XuanThucNgo/IOT_Project/About.jpg

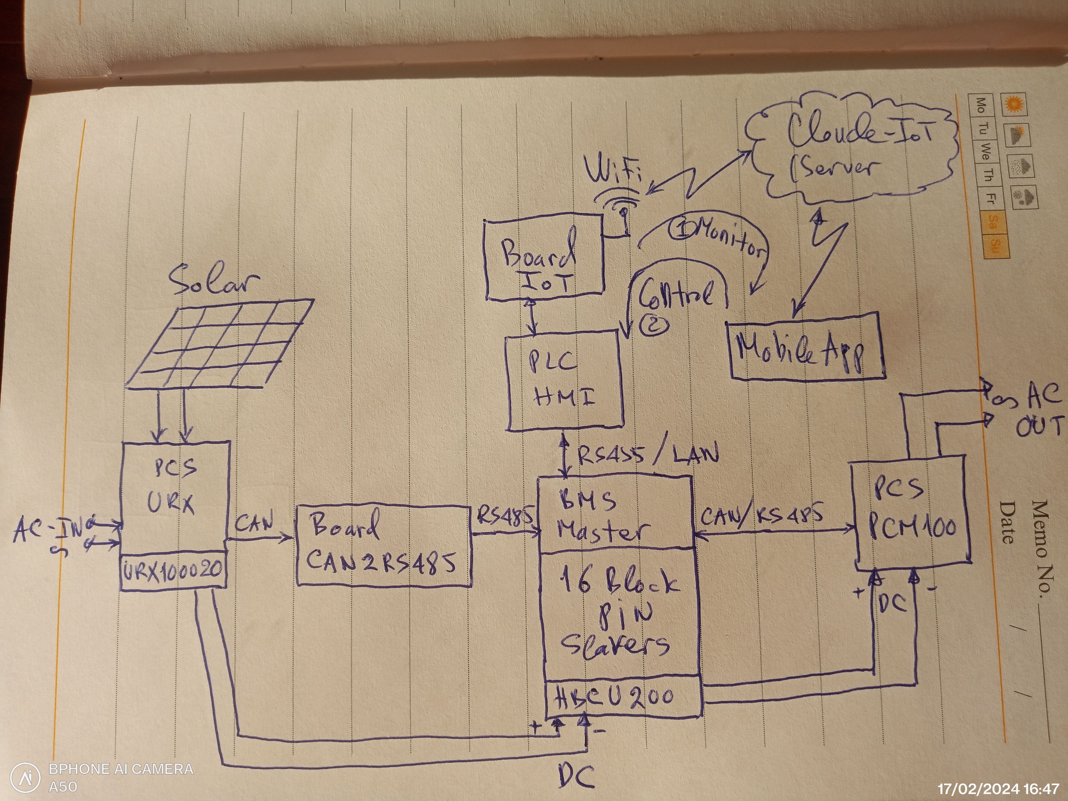
About.jpg
