XuanThucNgo/IOT_Project/trạm sạc xe máy điện.pdf

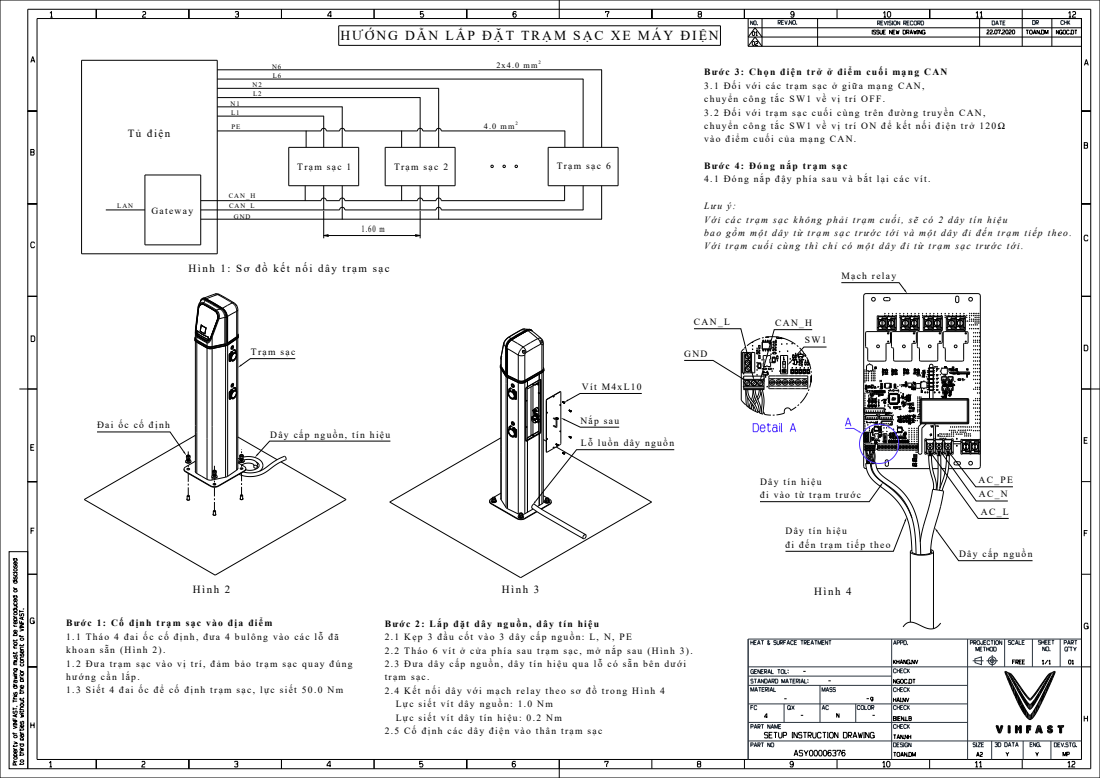
[picture p2: page 1]
Hình 2; Trạm sạc; Hình 3; Mạch relay; Tủ điện; Gateway LAN; Trạm sạc 1; Trạm sạc 2; Trạm sạc 6

HƯỚNG DẪN LẮP ĐẶT TRẠM SẠC XE MÁY ĐIỆN

Bước 3: Chọn điện trở ở điểm cuối mạng CAN
3.1 Đối với các trạm sạc ở giữa mạng CAN,
chuyển công tắc SW1 về vị trí OFF.
3.2 Đối với trạm sạc cuối cùng trên đường truyền CAN,
chuyển công tắc SW1 về vị trí ON để kết nối điện trở 120Ω
vào điểm cuối của mạng CAN.
Bước 4: Đóng nắp trạm sạc
4.1 Đóng nắp đậy phía sau và bắt lại các vít.
Lưu ý:
Với các trạm sạc không phải trạm cuối, sẽ có 2 dây tín hiệu
bao gồm một dây từ trạm sạc trước tới và một dây đi đến trạm tiếp theo.
Với trạm cuối cùng thì chỉ có một dây đi từ trạm sạc trước tới.

CAN_H
CAN_L
GND
Hình 1: Sơ đồ kết nối dây trạm sạc

Vít M4xL10
Nắp sau
Lỗ luồn dây nguồn

Đai ốc cố định

Dây cấp nguồn, tín hiệu

Dây tín hiệu
đi vào từ trạm trước
đi đến trạm tiếp theo
Hình 4

Dây cấp nguồn

Bước 1: Cố định trạm sạc vào địa điểm
1.1 Tháo 4 đai ốc cố định, đưa 4 bulông vào các lỗ đã
khoan sẵn (Hình 2).
1.2 Đưa trạm sạc vào vị trí, đảm bảo trạm sạc quay đúng
hướng cần lắp.
1.3 Siết 4 đai ốc để cố định trạm sạc, lực siết 50.0 Nm

Bước 2: Lắp đặt dây nguồn, dây tín hiệu
2.1 Kẹp 3 đầu cốt vào 3 dây cấp nguồn: L, N, PE
2.2 Tháo 6 vít ở cửa phía sau trạm sạc, mở nắp sau (Hình 3).
2.3 Đưa dây cấp nguồn, dây tín hiệu qua lỗ có sẵn bên dưới
trạm sạc.
2.4 Kết nối dây với mạch relay theo sơ đồ trong Hình 4
Lực siết vít dây nguồn: 1.0 Nm
Lực siết vít dây tín hiệu: 0.2 Nm
2.5 Cố định các dây điện vào thân trạm sạc
