XuanThucNgo/IOT_Project/DuAnSacXeDien_V1.0.pdf

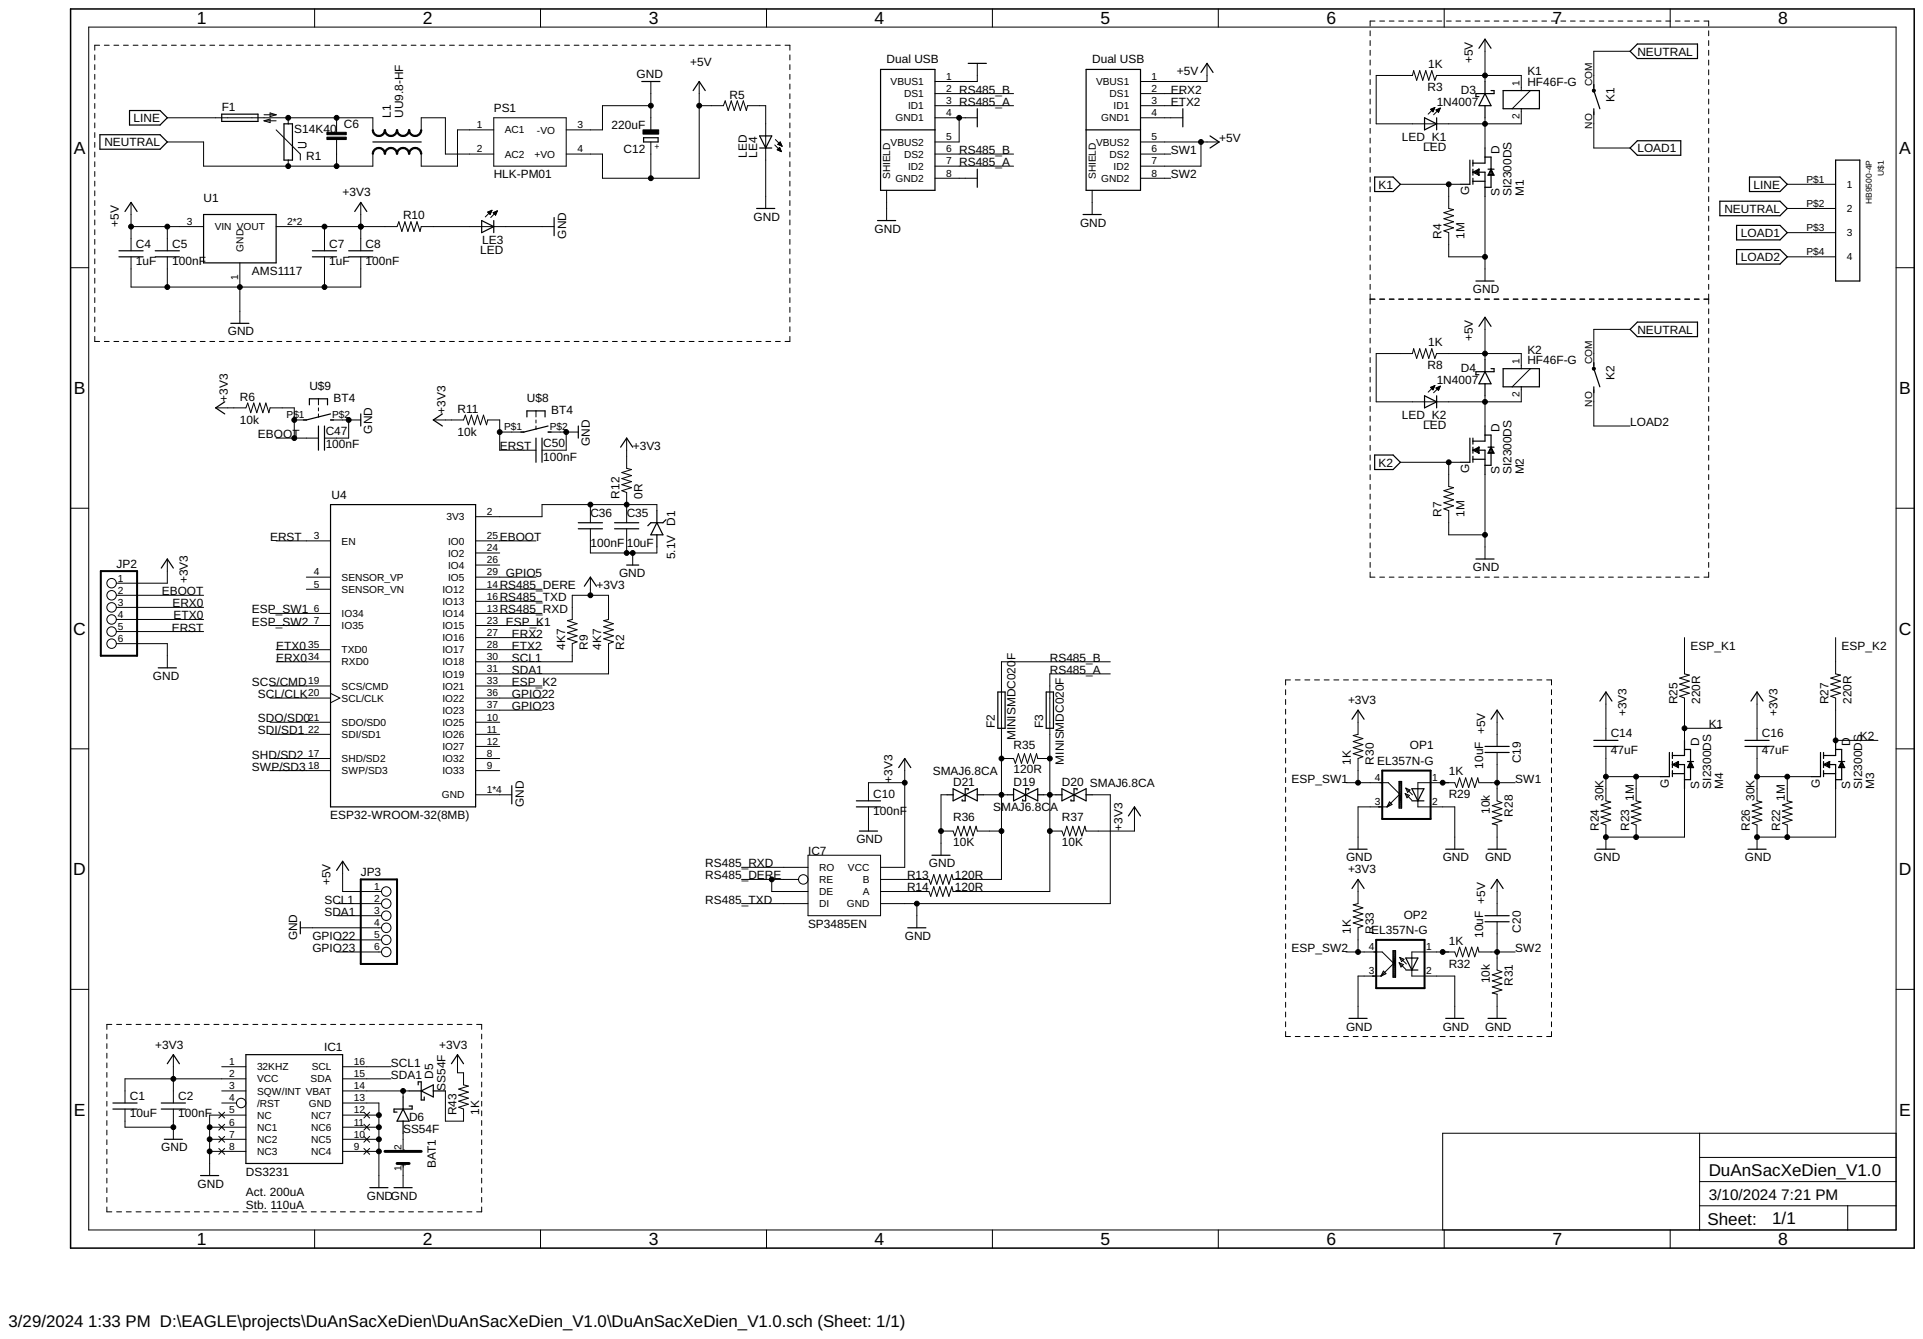
[picture p3: page 1]

3/29/2024 1:33 PM D:\EAGLE\projects\DuAnSacXeDien\DuAnSacXeDien_V1.0\DuAnSacXeDien_V1.0.sch (Sheet: 1/1)
