XuanThucNgo/IOT_Project/DuAnSacXeDien_V1.0.brd

## EAGLE design DuAnSacXeDien_V1.0.brd (2024-04-19)

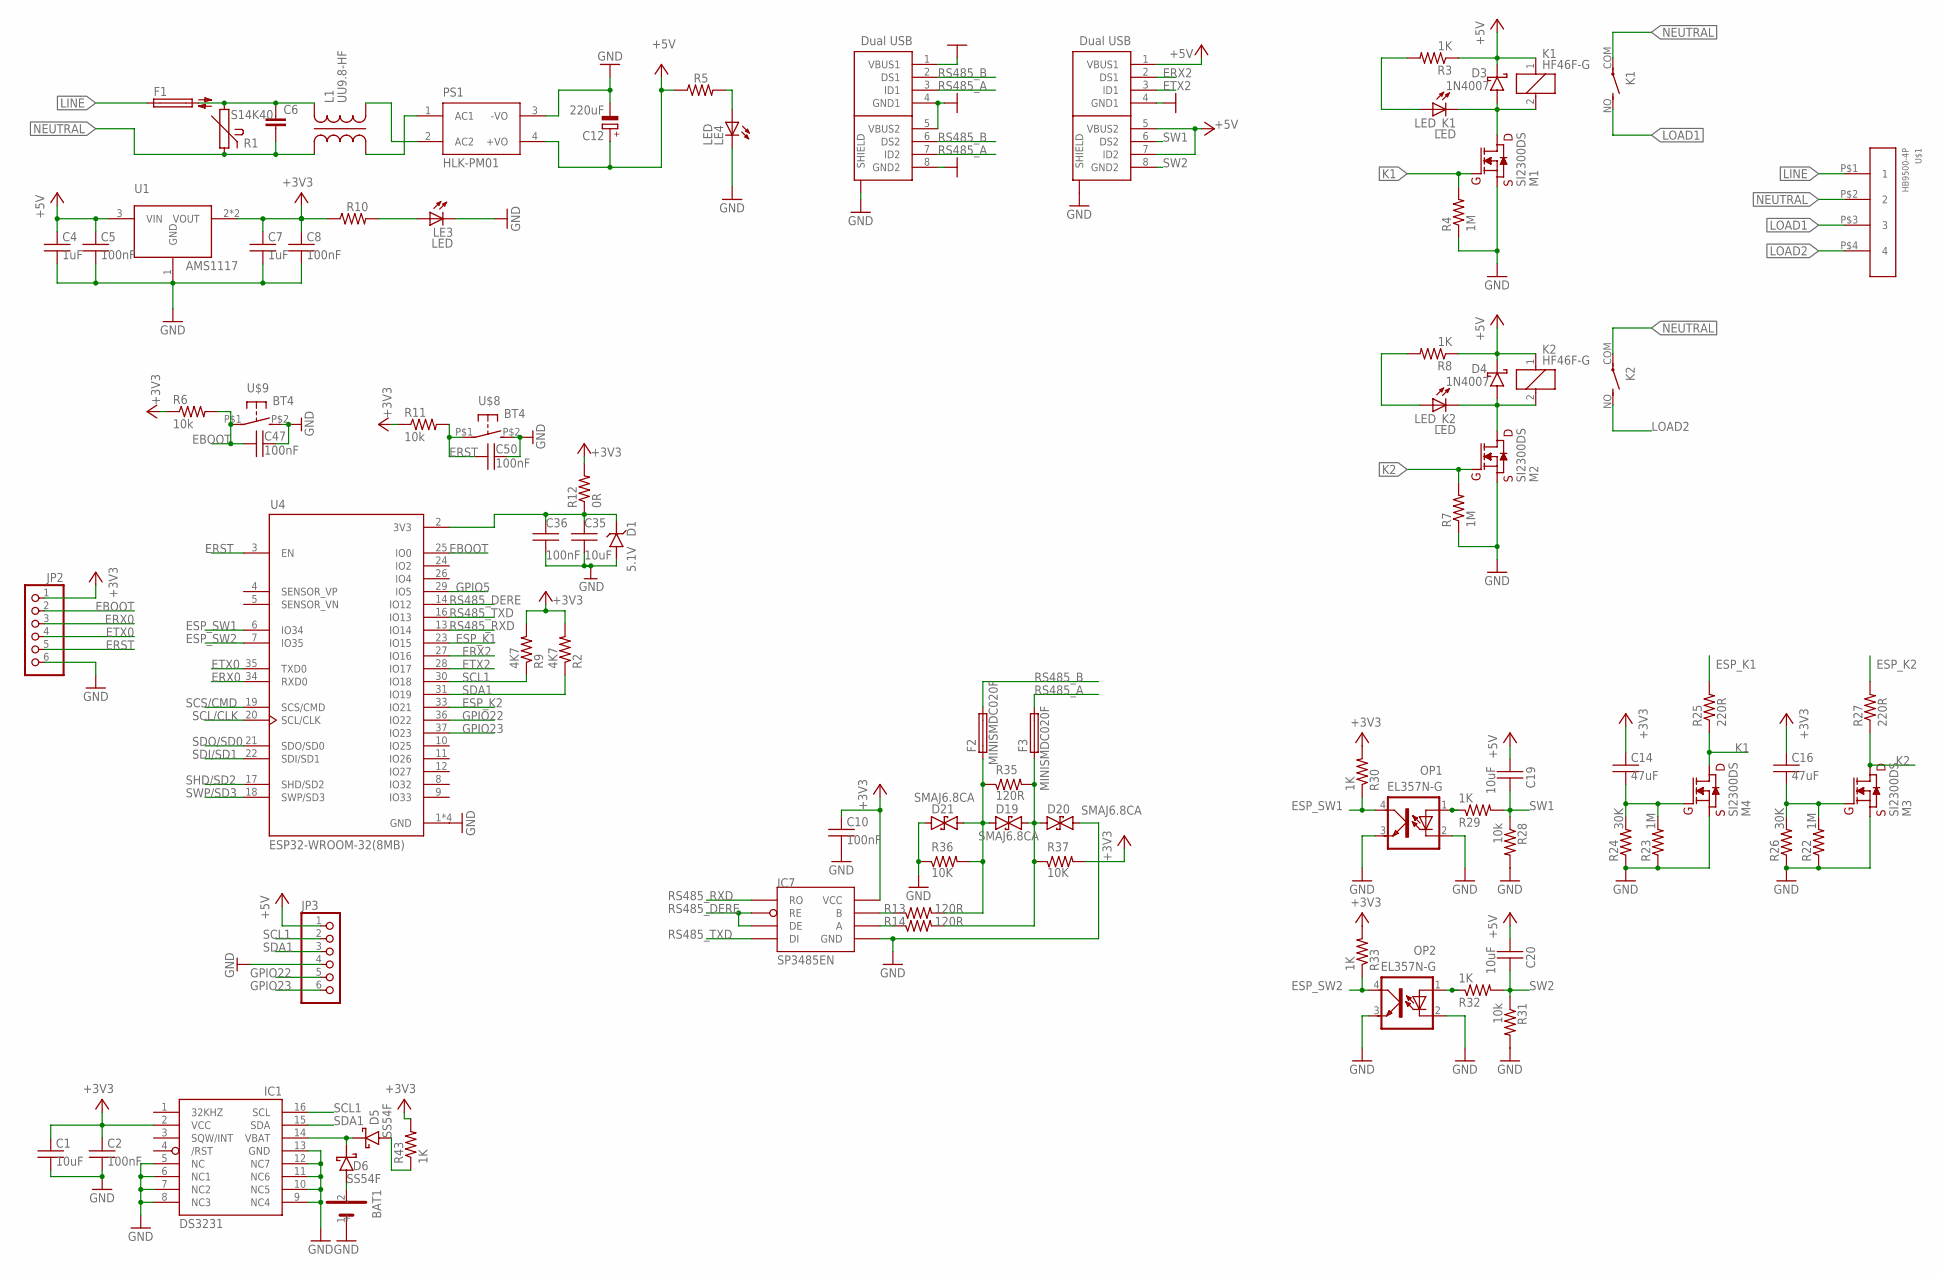
[picture p4: schematic DuAnSacXeDien_V1.0.sch]

Parts:
BAT1: CR1220
C1, C19, C20, C35: 10uF; 0603
C2, C5, C8, C10, C36, C47, C50: 100nF; 0603
C4, C7: 1uF; 0603
C6: C-EU150-064X183; C150-064X183
C12: 220uF; 153CLV-0605
C14, C16: 47uF; 0805
D1: 5.1V; SOD123
D3, D4: 1N4007; SMAF
D5, D6: SS54F; SMAF
D19, D20, D21: SMAJ6.8CA; DO-214AC-BI
F1: TE5
F2, F3: MINISMDC020F; C1812
IC1: DS3231/SO; SO16W
IC7: SP3485EN; SOIC-8
JP2: PINHD-1X6; 1X06
JP3: PINHD-1X6/LONG; 1X06
K1, K2: HF46F-G; LD
L1: UU9.8-HF
LE3, LE4: LED; LED3MM
LED_K1, LED_K2: LED; LED3MM
M1, M2, M3, M4: SI2300DS; SOT23(1)
OP1, OP2: EL357N-G; SOP4
PS1: HLK-PM01; HLK-PMXX
R1: S14K40
R2, R9: 4K7; 0603
R3, R5, R8, R10, R29, R30, R32, R33, R43: 1K; 0603
R4, R7, R22, R23: 1M; 0603
R6, R11, R28, R31: 10k; 0603
R12: 0R; 0603
R13, R14, R35: 120R; 0603
R24, R26: 30K; 0603
R25, R27: 220R; 0603
R36, R37: 10K; 0603
U1: LD1117; SOT223-3.3
U4: ESP32-WROOM-32(8MB); MODULE_ESP32-WROOM-32(8MB)
U$1: HB9500-4P
U$2, U$7: DUAL_USB
U$8, U$9: BT4

Connections:
+3V3: C1.1, C2.1, C7.1, C8.1, C10.1, C14.1, C16.1, IC1.2 (VCC), IC7.8 (VCC), JP2.1, R2.2, R6.1, R9.2, R10.1, R11.1, R12.2, R30.2, R33.2, R37.2, R43.2, U1.2 (VOUT), U1.4 (VOUT)
+5V: C4.1, C5.1, C12.+, C19.1, C20.1, D3.C, D4.C, JP3.1, K1.1, K2.1, PS1.4 (+VO), R3.1, R5.1, R8.1, U1.3 (VIN), U$2.1 (VBUS1), U$2.5 (VBUS2), U$2.7 (ID2)
EBOOT: C47.1, JP2.2, R6.2, U4.25 (IO0), U$9.P$1 (1)
ERST: C50.1, JP2.5, R11.2, U4.3 (EN), U$8.P$1 (1)
ERX0: JP2.3, U4.34 (RXD0)
ERX2: U4.27 (IO16), U$2.2 (DS1)
ESP_K1: R25.2, U4.23 (IO15)
ESP_K2: R27.2, U4.33 (IO21)
ESP_SW1: OP1.4 (COL), R30.1, U4.6 (IO34)
ESP_SW2: OP2.4 (COL), R33.1, U4.7 (IO35)
ETX0: JP2.4, U4.35 (TXD0)
ETX2: U4.28 (IO17), U$2.3 (ID1)
GND: BAT1.1 (-), C1.2, C2.2, C4.2, C5.2, C7.2, C8.2, C10.2, C12.-, C35.2, C36.2, C47.2, C50.2, D1.A, D20.2, D21.1, IC1.5 (NC), IC1.6 (NC1), IC1.7 (NC2), IC1.8 (NC3), IC1.9 (NC4), IC1.10 (NC5), IC1.11 (NC6), IC1.12 (NC7), IC1.13 (GND), IC7.5 (GND), JP2.6, JP3.4, LE3.K (C), LE4.K (C), M1.2 (S), M2.2 (S), M3.2 (S), M4.2 (S), OP1.2 (C), OP1.3 (EMIT), OP2.2 (C), OP2.3 (EMIT), PS1.3 (-VO), R4.1, R7.1, R22.1, R23.1, R24.1, R26.1, R28.2, R31.2, R36.1, U1.1 (GND), U4.1 (GND), U4.15 (GND), U4.38 (GND), U4.39 (GND), U$2.4 (GND1), U$2.TAB1 (SHIELD), U$2.TAB2 (SHIELD), U$2.TAB3 (SHIELD), U$2.TAB4 (SHIELD), U$7.1 (VBUS1), U$7.4 (GND1), U$7.5 (VBUS2), U$7.8 (GND2), U$7.TAB1 (SHIELD), U$7.TAB2 (SHIELD), U$7.TAB3 (SHIELD), U$7.TAB4 (SHIELD), U$8.P$2 (2), U$9.P$2 (2)
GPIO5: U4.29 (IO5)
GPIO22: JP3.5, U4.36 (IO22)
GPIO23: JP3.6, U4.37 (IO23)
K1: M1.1 (G), M4.3 (D), R4.2, R25.1
K2: M2.1 (G), M3.3 (D), R7.2, R27.1
LINE: F1.1, U$1.P$1 (1)
LOAD1: K1.NO (S), U$1.P$3 (3)
LOAD2: K2.NO (S), U$1.P$4 (4)
unnamed: D3.A, K1.2, LED_K1.K (C), M1.3 (D)
unnamed: D19.1, D21.2, F2.1, R13.2, R35.1, R36.2
unnamed: D4.A, K2.2, LED_K2.K (C), M2.3 (D)
unnamed: LED_K2.A, R8.2
unnamed: OP1.1 (A), R29.1
unnamed: LED_K1.A, R3.2
unnamed: D19.2, D20.1, F3.1, R14.2, R35.2, R37.1
unnamed: OP2.1 (A), R32.1
unnamed: C16.2, M3.1 (G), R22.2, R26.2
unnamed: C6.1, F1.2, L1.4, R1.2
unnamed: IC7.6 (A), R14.1
unnamed: IC7.7 (B), R13.1
unnamed: LE4.A, R5.2
unnamed: C35.1, C36.1, D1.C, R12.1, U4.2 (3V3)
unnamed: BAT1.2 (+), D6.A
unnamed: L1.3, PS1.2 (AC2)
unnamed: L1.2, PS1.1 (AC1)
unnamed: D5.A, R43.1
unnamed: C14.2, M4.1 (G), R23.2, R24.2
unnamed: LE3.A, R10.2
NEUTRAL: C6.2, K1.COM, K2.COM, L1.1, R1.1, U$1.P$2 (2)
RS485_A: F3.2, U$7.3 (ID1), U$7.7 (ID2)
RS485_B: F2.2, U$7.2 (DS1), U$7.6 (DS2)
RS485_DERE: IC7.2 (RE), IC7.3 (DE), U4.14 (IO12)
RS485_RXD: IC7.1 (RO), U4.13 (IO14)
RS485_TXD: IC7.4 (DI), U4.16 (IO13)
SCL1: IC1.16 (SCL), JP3.2, R9.1, U4.30 (IO18)
SCL/CLK: U4.20 (SCL/CLK)
SCS/CMD: U4.19 (SCS/CMD)
SDA1: IC1.15 (SDA), JP3.3, R2.1, U4.31 (IO19)
SDI/SD1: U4.22 (SDI/SD1)
SDO/SD0: U4.21 (SDO/SD0)
SHD/SD2: U4.17 (SHD/SD2)
SW1: C19.2, R28.1, R29.2, U$2.6 (DS2)
SW2: C20.2, R31.1, R32.2, U$2.8 (GND2)
SWP/SD3: U4.18 (SWP/SD3)
VBAT: D5.C, D6.C, IC1.14 (VBAT)

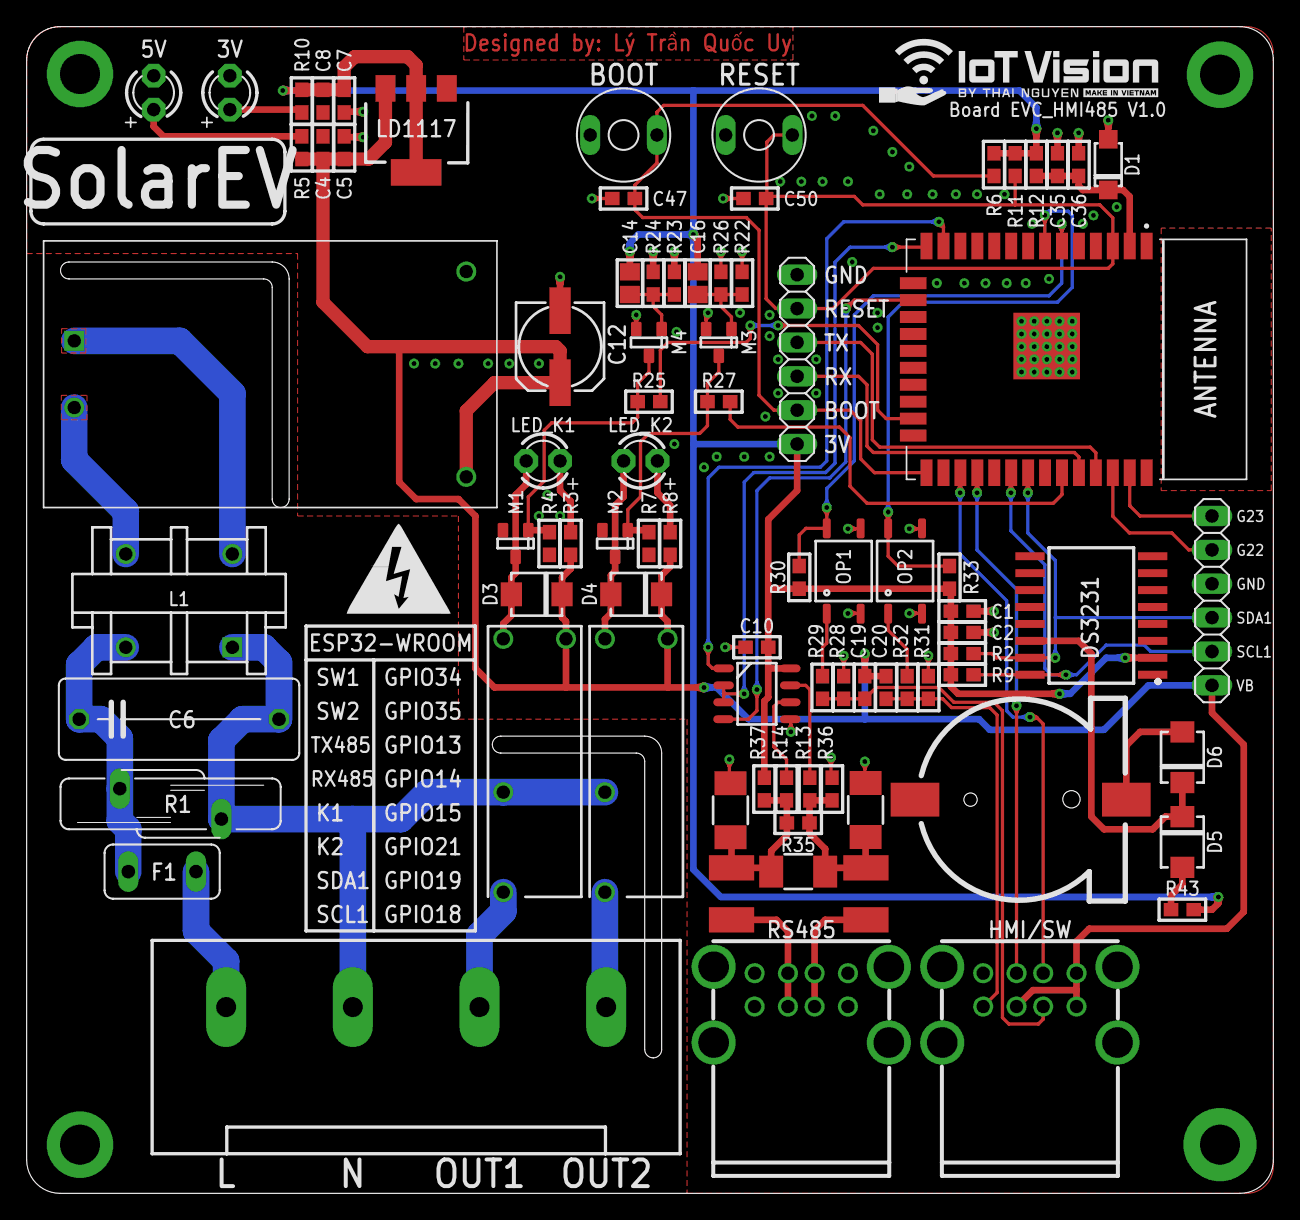
[picture p5: board DuAnSacXeDien_V1.0.brd from above]

Board: 2 copper layers, 93.5 x 87.5 mm, 84 parts (0 on the bottom side), 51 nets.
